raphaelchang/dragonflyte-hardware/Dragonflyte/Boards/Dragonfleye/CAD/LensMount.STEP

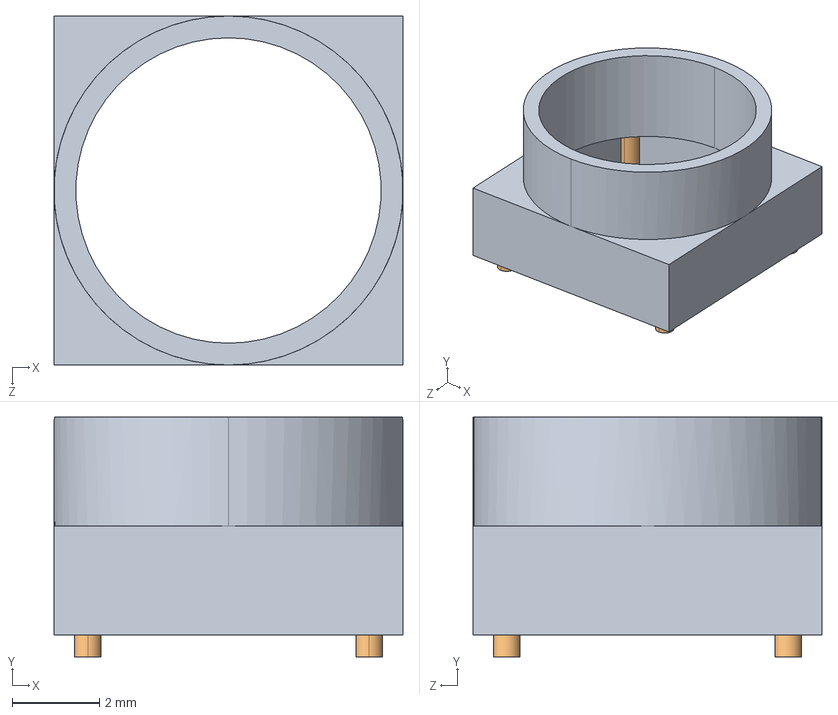
[picture p1: CAD file, 2018-10-28]
Dragonflyte/Boards/Dragonfleye/CAD/LensMount.STEP
8.00 x 5.50 x 8.00 mm
