raphaelchang/dragonflyte-hardware/Dragonflyte/Boards/Dragonfleye/Project Outputs for Dragonfleye/STEP/Dragonfleye.step

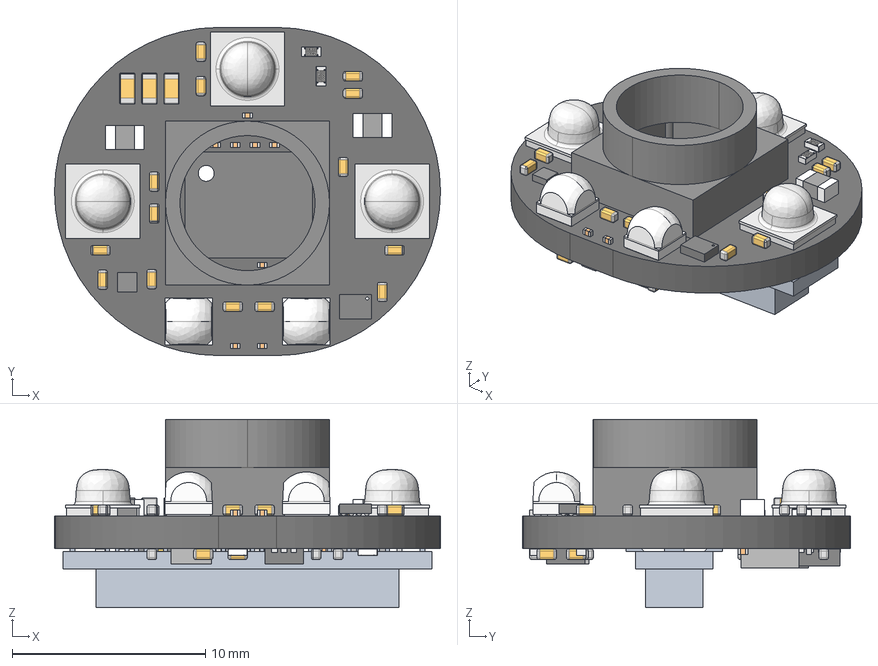
[picture p2: CAD file, 2018-01-28]
Dragonflyte/Boards/Dragonfleye/Project Outputs for Dragonfleye/STEP/Dragonfleye.step
20.0 x 17.0 x 9.75 mm
Board
Open_CASCADE_STEP_translator_6.8_2.1
Open_CASCADE_STEP_translator_6.8_2.2.1
ball x 56
Extruded x 43
User_Library-RESC1005X04N x 7
CREE,_XLamp_XB-H_RGB15724527 x 2
CAPC1005X55N_EIA_0402 x 23
LQM21NN0_1-2_2u x 2
60R-JMDSS-G-1-TF(S)
SFH_4715AS_110615_geometry_RGB13421772 x 3
Open_CASCADE_STEP_translator_6.8_14.1
Open_CASCADE_STEP_translator_6.8_14.2.1
Open_CASCADE_STEP_translator_6.8_24.1
Open_CASCADE_STEP_translator_6.8_24.2.1
Thermal_Shape x 2
Open_CASCADE_STEP_translator_6.8_24.4.1 x 6
Open_CASCADE_STEP_translator_6.8_12.1
Open_CASCADE_STEP_translator_6.8_12.2.1
Open_CASCADE_STEP_translator_6.8_12.4.1 x 28
CAPC1608X92N_EIA_0603 x 3
LensMount_RGB4408131
