raphaelchang/dragonflyte-hardware/Dragonflyte/Boards/Dragonflyte/CAD/Outline.SLDPRT

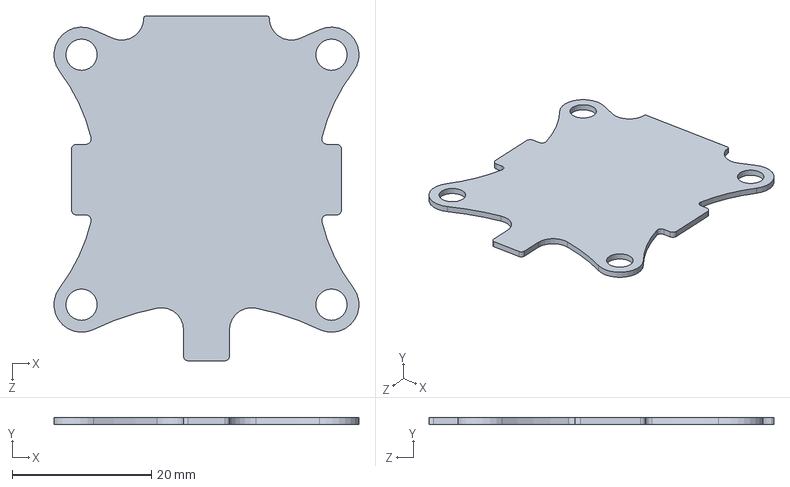
[picture p3: CAD file, 2018-01-07]
Dragonflyte/Boards/Dragonflyte/CAD/Outline.SLDPRT
43.8 x 1.00 x 49.5 mm
