raphaelchang/dragonflyte-hardware/Dragonflyte/Boards/Dragonfleye/CAD/Outline.SLDPRT

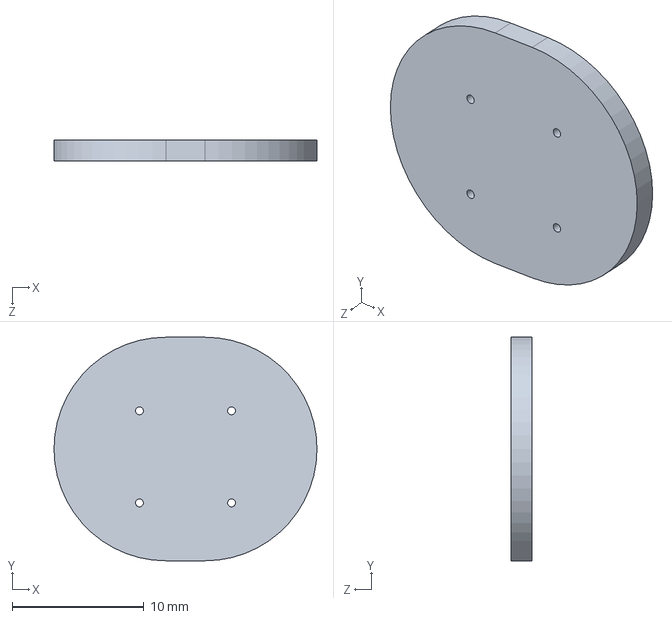
[picture p4: CAD file, 2018-01-25]
Dragonflyte/Boards/Dragonfleye/CAD/Outline.SLDPRT
20.0 x 17.0 x 1.60 mm
