raphaelchang/dragonflyte-hardware/(list of files, cad)

Other CAD files:
Dragonflyte/Boards/Dragonfleye/CAD/CameraSketch.SLDPRT
Dragonflyte/Boards/Dragonfleye/CAD/LensMount.SLDPRT
Dragonflyte/Boards/Dragonfleye/CAD/Outline.DXF
Dragonflyte/Boards/Dragonflyte/CAD/Outline.DXF
