raphaelchang/dragonflyte-hardware/Dragonflyte/Boards/Dragonfleye/Project Outputs for Dragonfleye/PDF/Dragonfleye.PDF

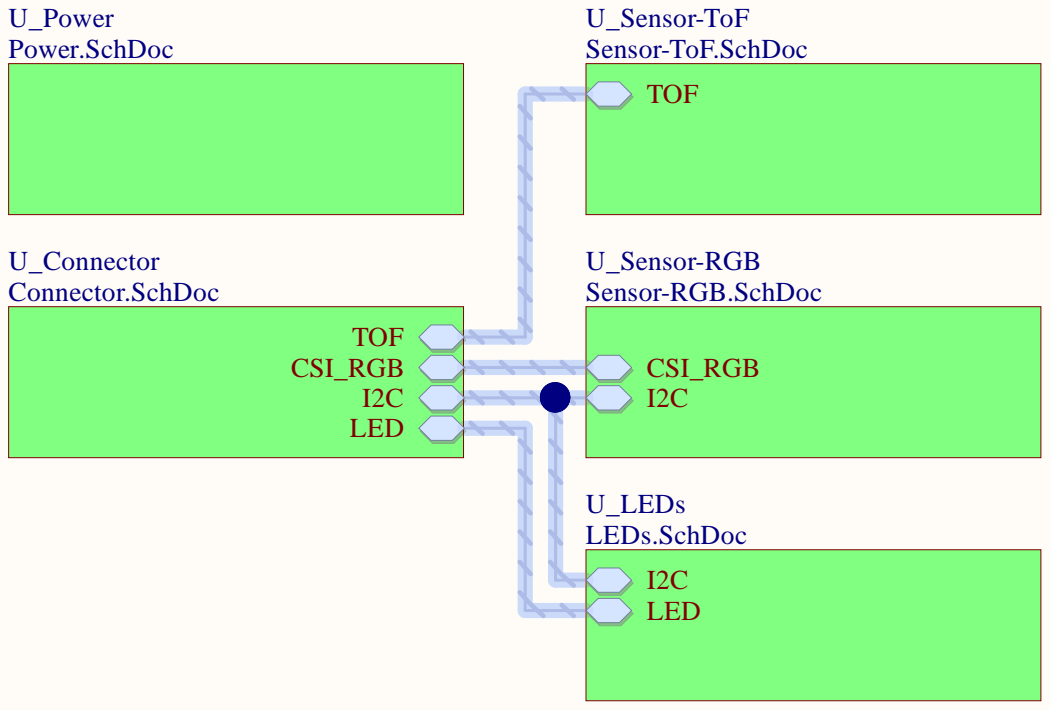
[picture p5: page 1]

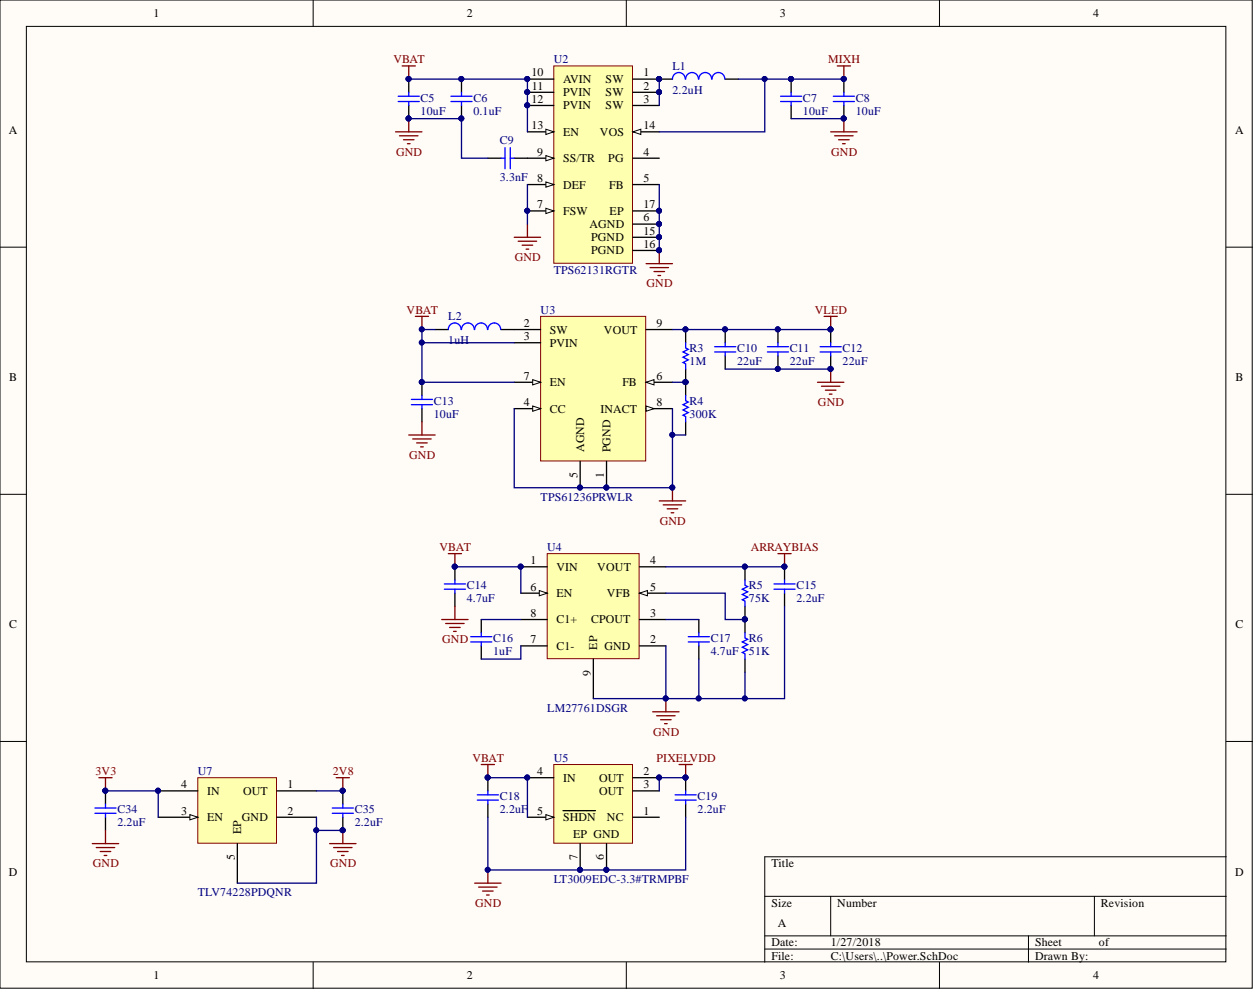
[picture p6: page 2]

1uH | PVIN 3

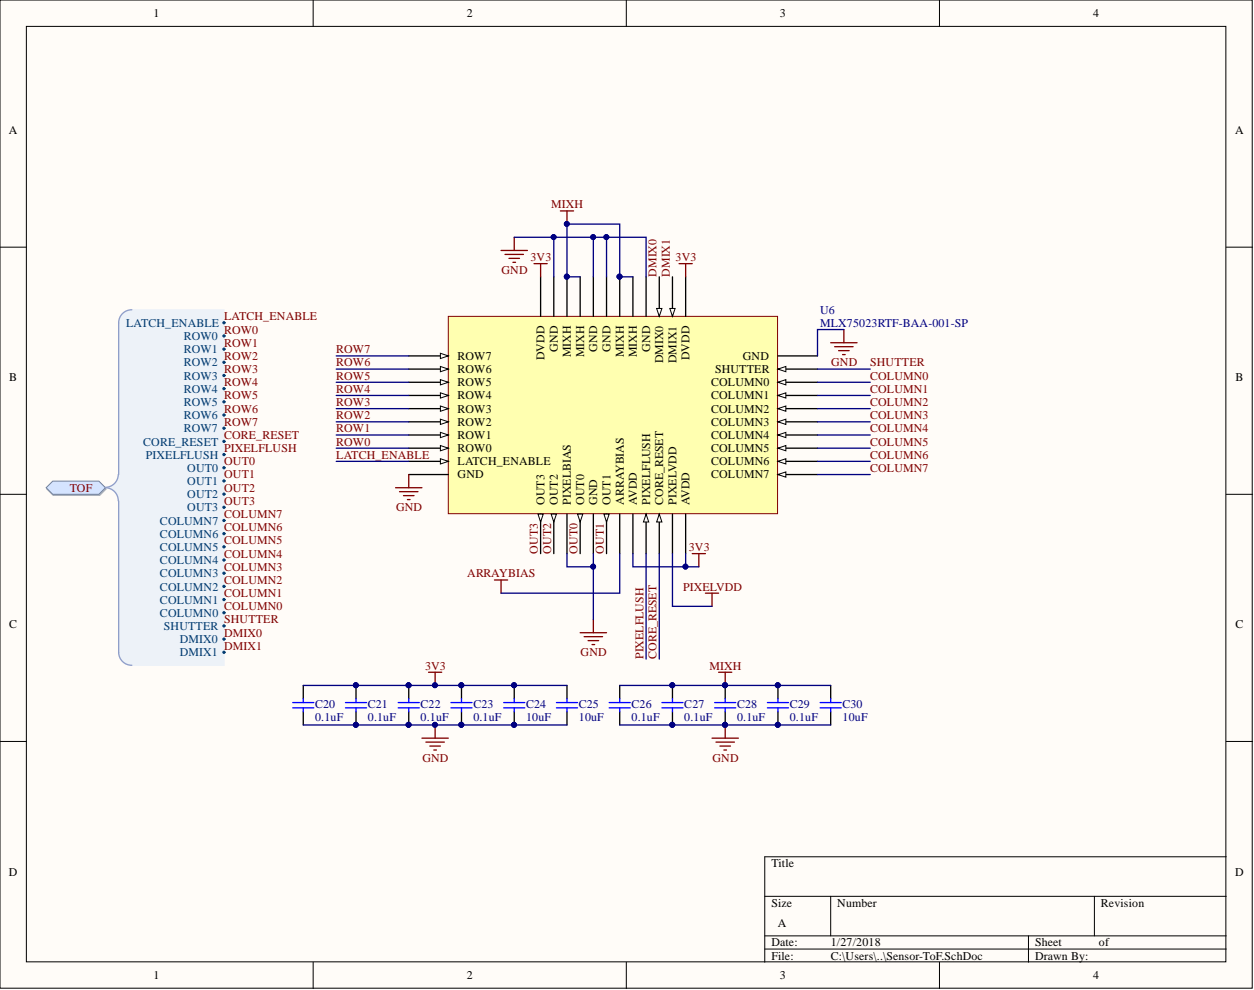
[picture p7: page 3]

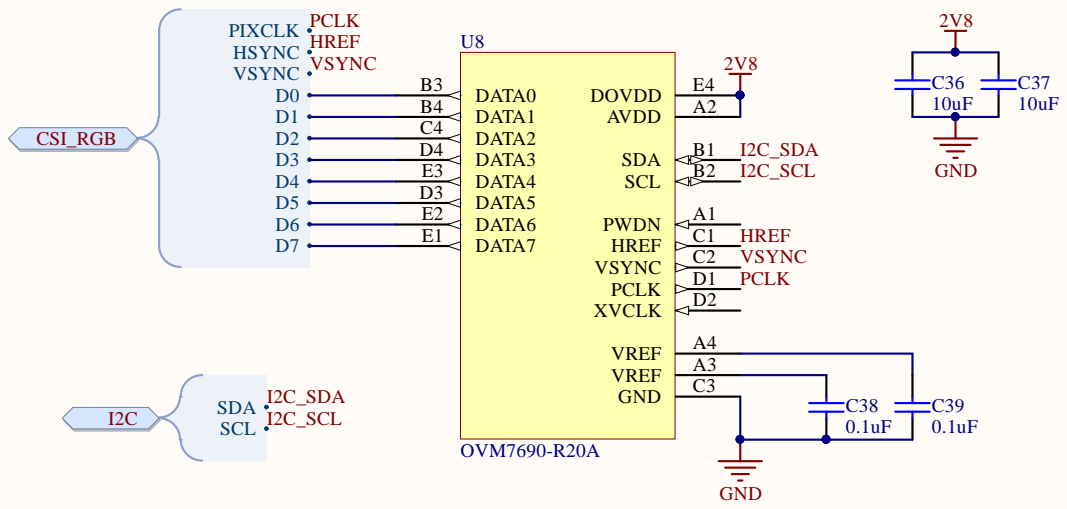
[picture p8: page 4]

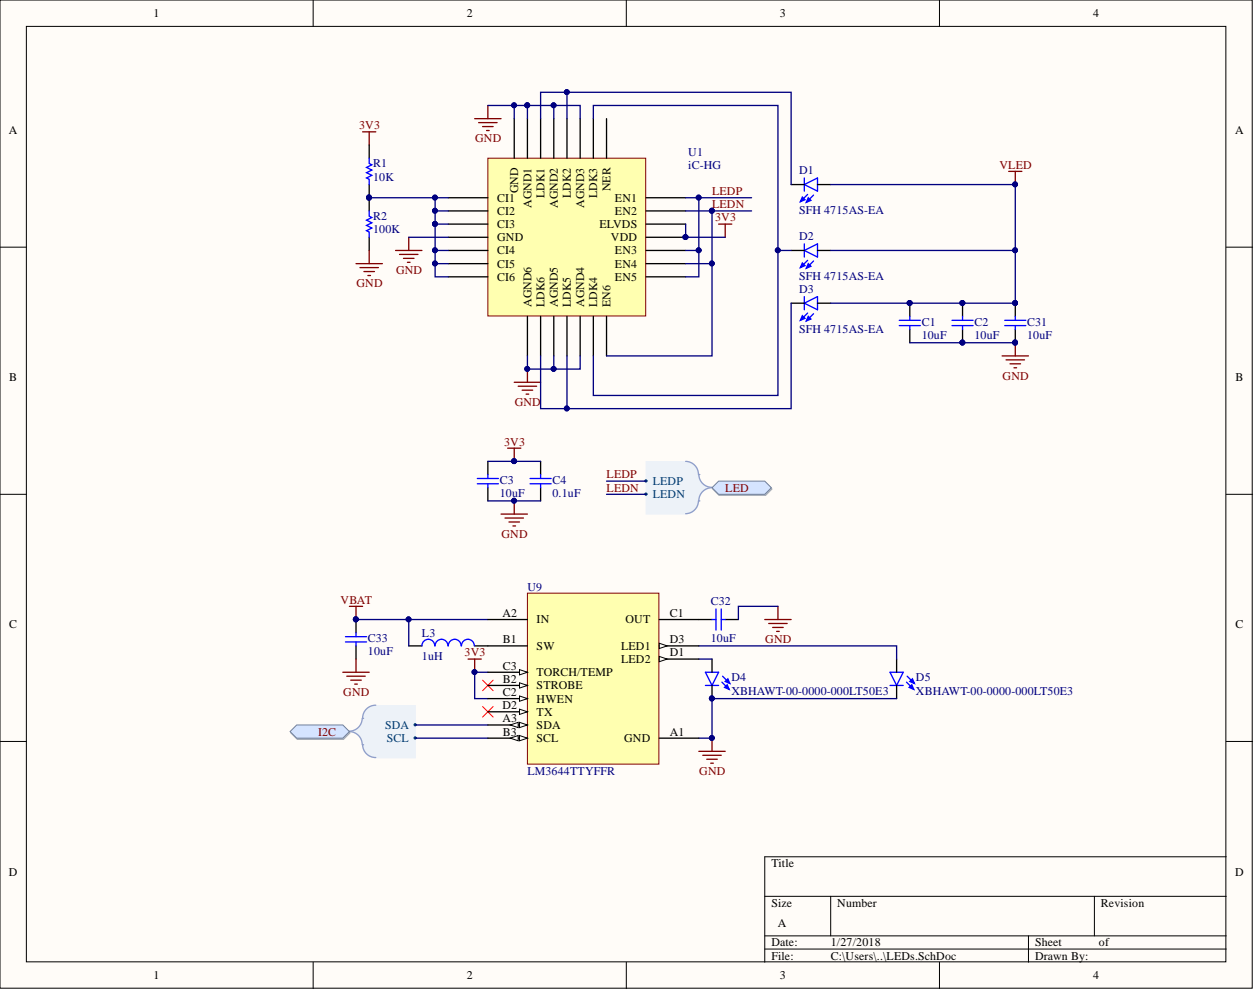
[picture p9: page 5]

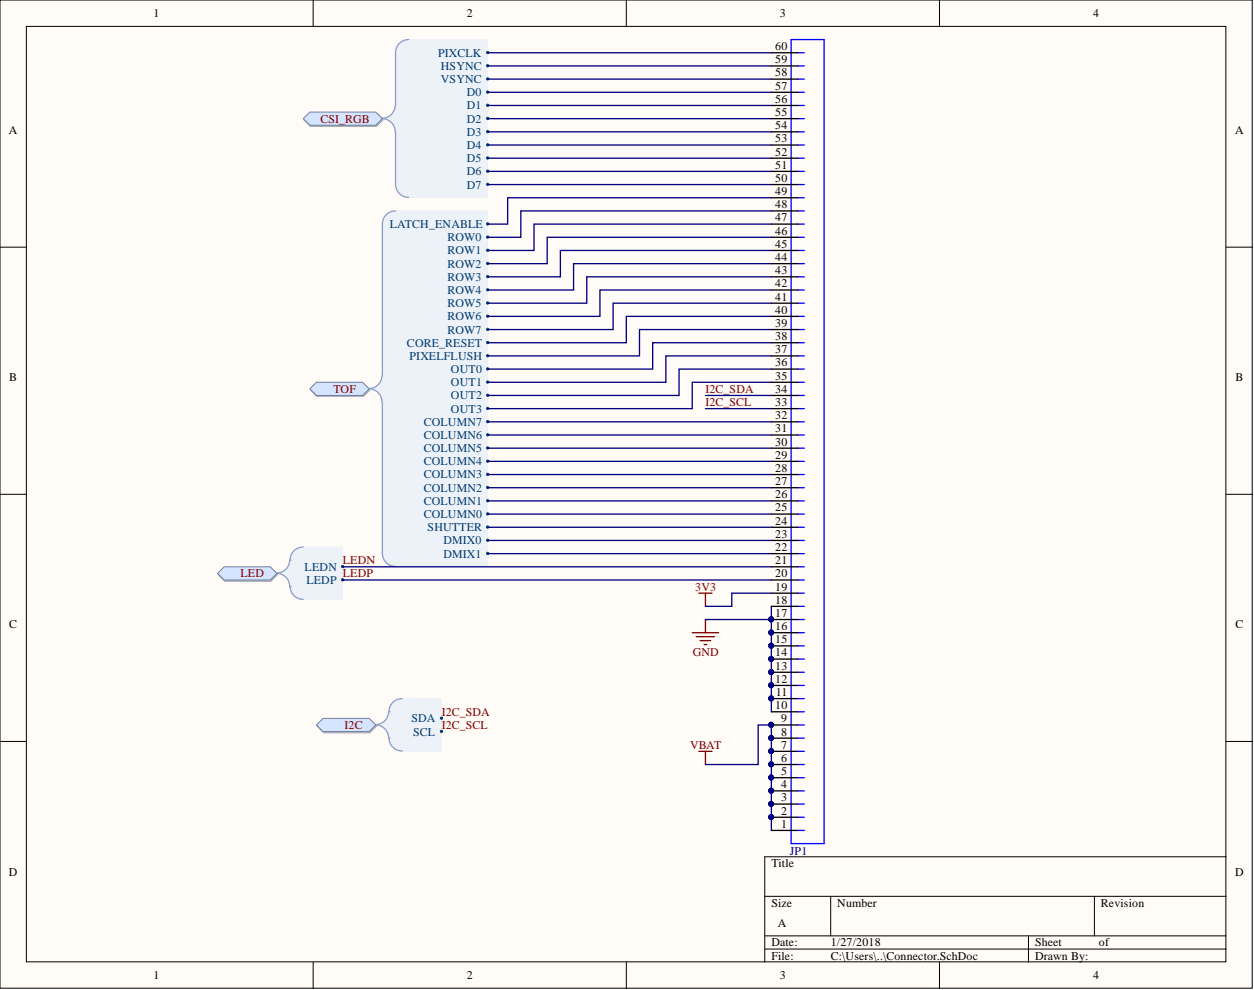
[picture p10: page 6]

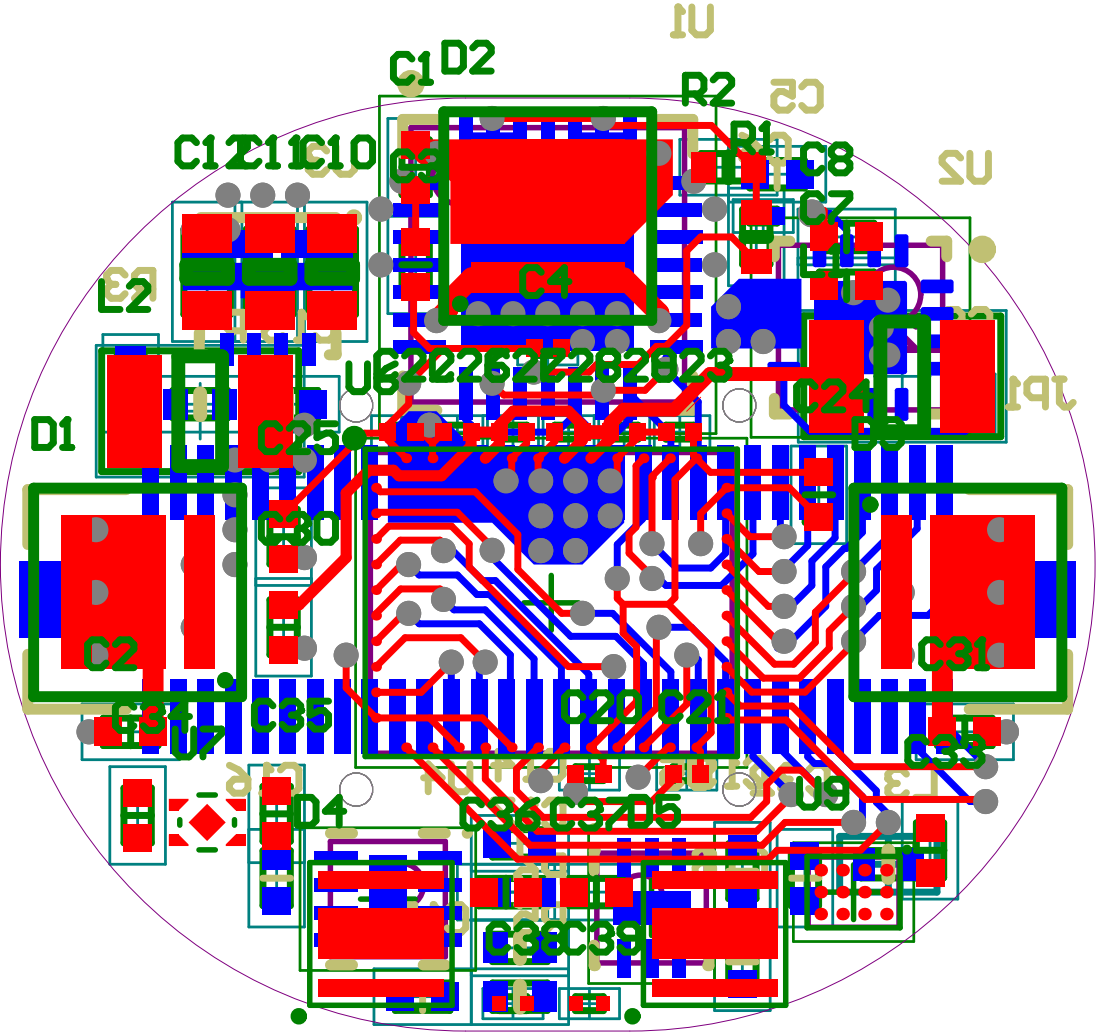
[picture p11: page 7]

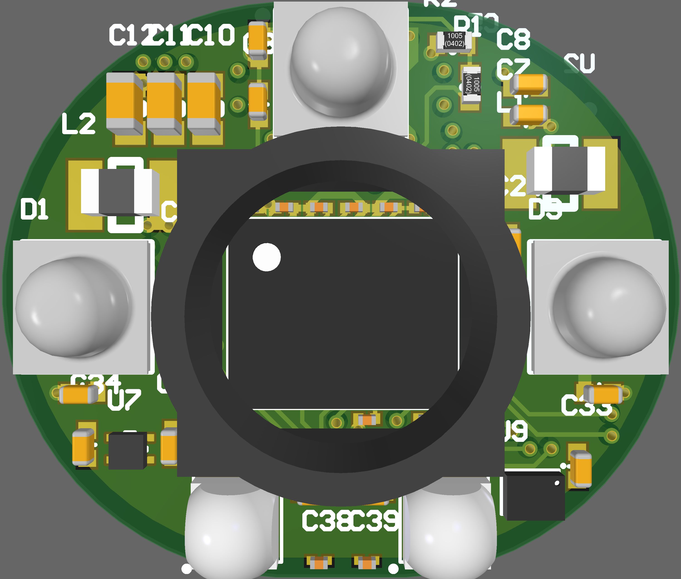
[picture p12: page 8]

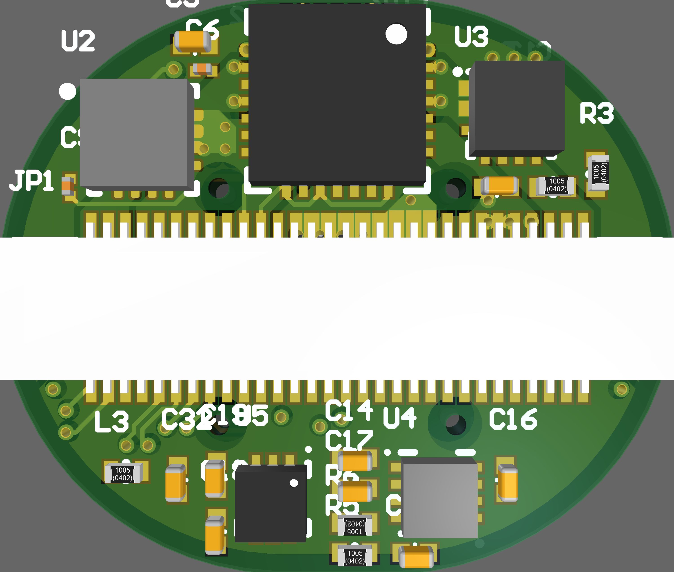
[picture p13: page 9]
