raphaelchang/dragonflyte-hardware/(list of files, drawings)

Other design files:
Dragonflyte/Boards/Dragonfleye/Connector.SchDoc
Dragonflyte/Boards/Dragonfleye/Dragonfleye.PcbDoc
Dragonflyte/Boards/Dragonfleye/Dragonfleye.PrjPcb
Dragonflyte/Boards/Dragonfleye/Dragonfleye.SchDoc
Dragonflyte/Boards/Dragonfleye/LEDs.SchDoc
Dragonflyte/Boards/Dragonfleye/Power.SchDoc
Dragonflyte/Boards/Dragonfleye/Sensor-RGB.SchDoc
Dragonflyte/Boards/Dragonfleye/Sensor-ToF.SchDoc
Dragonflyte/Boards/Dragonflyte/Cameras.SchDoc
Dragonflyte/Boards/Dragonflyte/Components.SchLib
Dragonflyte/Boards/Dragonflyte/Dragonflyte.PrjPcb
Dragonflyte/Boards/Dragonflyte/Dragonflyte.SchDoc
Dragonflyte/Boards/Dragonflyte/Footprints.PcbLib
Dragonflyte/Boards/Dragonflyte/MicrophoneArray.SchDoc
Dragonflyte/Boards/Dragonflyte/MPU-Control.SchDoc
Dragonflyte/Boards/Dragonflyte/MPU-Memory.SchDoc
Dragonflyte/Boards/Dragonflyte/MPU-Peripherals.SchDoc
Dragonflyte/Boards/Dragonflyte/MPU-Power.SchDoc
Dragonflyte/Boards/Dragonflyte/PowerCommConnector.SchDoc
Dragonflyte/Boards/Dragonflyte/PWMDriver.SchDoc
Dragonflyte/Boards/Dragonflyte/Sensors.SchDoc
Dragonflyte/Boards/Dragonflyte/Supplies.SchDoc
Dragonflyte/Boards/Dragonflyte/USB.SchDoc
Dragonflyte/Boards/Dragonflyte/UWB.SchDoc
Dragonflyte/Boards/Dragonflyte/WiFi.SchDoc
Dragonflyte/Dragonflyte.PcbDoc
