raphaelchang/dragonflyte-hardware/(commit log)

2017-11-23 Started design
    [MPU-Control.SchDoc, MPU-Memory.SchDoc, MPU-Power.SchDoc, Power.SchDoc, Supplies.SchDoc, TinyTOF-Body.PrjPcb, TinyTOF-Lens.PrjPcb]
2017-11-25 DDR3 routing is such a mess
    [MPU-Memory.SchDoc, MPU-Power.SchDoc, TinyTOF-Body.PcbDoc, TinyTOF-Body.PrjPcb]
2017-11-26 Match all the lengths!!!!!
    [TinyTOF-Body.PcbDoc]
2017-11-26 balanced clocks
    [TinyTOF-Body.PcbDoc]
2017-11-26 +termination resistor
    [MPU-Memory.SchDoc, TinyTOF-Body.PcbDoc]
2017-12-02 Finished processor schematics, started layout
    [Components.SchLib, Footprints.PcbLib, MPU-Control.SchDoc, MPU-Memory.SchDoc, MPU-Peripherals.SchDoc, MPU-Power.SchDoc, Supplies.SchDoc, TinyTOF-Body.PcbDoc]
2017-12-08 Add logo
    [Dragonflyte.PrjPcb, Outline.DXF, Outline.SLDPRT]
2017-12-10 made smaller
    [Outline.DXF, Outline.SLDPRT]
2017-12-14 continuing schematic
    [Cameras.SchDoc, Components.SchLib, Dragonflyte.PrjPcb, Dragonflyte.SchDoc, Footprints.PcbLib, MPU-Control.SchDoc, MPU-Peripherals.SchDoc, MicrophoneArray.SchDoc]
2017-12-14 Add cameras
    [Cameras.SchDoc, Components.SchLib, Dragonflyte.PrjPcb, Dragonflyte.SchDoc, Footprints.PcbLib]
2017-12-14 Finished schematic for now
    [Cameras.SchDoc, Dragonflyte.PrjPcb, Dragonflyte.SchDoc, MPU-Control.SchDoc, MPU-Peripherals.SchDoc, MicrophoneArray.SchDoc, PowerBoardConnector.SchDoc, Sensors.SchDoc]
2017-12-16 Almost done with layout, started routing
    [Cameras.SchDoc, MicrophoneArray.SchDoc, PowerBoardConnector.SchDoc, Supplies.SchDoc]
2017-12-16 more layout
    [Supplies.SchDoc]
2017-12-17 outline changes
    [MPU-Peripherals.SchDoc, Outline.DXF, Outline.SLDPRT]
2018-01-03 Finished placement
    [Cameras.SchDoc, Dragonflyte.PrjPcb, Sensors.SchDoc]
2018-01-06 Small layout changes
    [Footprints.PcbLib, Outline.DXF, Outline.SLDPRT]
2018-01-07 Started camera routing
    [Dragonflyte.SchDoc, Outline.DXF, Outline.SLDPRT, Sensors.SchDoc, Supplies.SchDoc]
2018-01-08 Finished most routing
    [MPU-Control.SchDoc, PowerBoardConnector.SchDoc, Supplies.SchDoc, USB.SchDoc]
2018-01-18 antenna layout changes
    [Components.SchLib, Footprints.PcbLib, WiFi.SchDoc]
2018-01-22 Started dragonfleye
    [CameraSketch.SLDPRT, Dragonfleye.PcbDoc, Dragonfleye.PrjPcb, Dragonfleye.step, LensMount.SLDPRT, LensMount.STEP, Outline.DXF, Outline.SLDPRT]
2018-01-24 Mostly finished camera schematic
    [Cameras.SchDoc, Connector.SchDoc, Dragonfleye.PcbDoc, Dragonfleye.PrjPcb, Dragonfleye.SchDoc, Dragonfleye.step, Dragonflyte.PrjPcb, LEDs.SchDoc]
2018-01-25 Dragonfleye routing
    [Cameras.SchDoc, Connector.SchDoc, Dragonfleye.PcbDoc, Dragonfleye.PrjPcb, Dragonfleye.SchDoc, Dragonfleye.step, LEDs.SchDoc, Outline.DXF]
2018-01-27 Add white LEDs
    [Dragonfleye.PcbDoc, Dragonfleye.PrjPcb, Dragonfleye.SchDoc, Dragonfleye.step, LEDs.SchDoc, Power.SchDoc, Sensor-RGB.SchDoc]
2018-01-28 Output pdfs
    [CameraSketch.SLDPRT, Dragonfleye.PcbDoc, Dragonfleye.PrjPcb, Dragonfleye.step, Dragonflyte.PrjPcb, LensMount.SLDPRT, LensMount.STEP, Outline.DXF]
2018-01-28 Fix sheet ordering
    [Cameras.SchDoc, Connector.SchDoc, Dragonfleye.SchDoc, Dragonflyte.PrjPcb, Dragonflyte.SchDoc, LEDs.SchDoc, MPU-Control.SchDoc, MPU-Memory.SchDoc]
2018-06-11 Restructure as multiboard project
    [CameraSketch.SLDPRT, Cameras.SchDoc, Components.SchLib, Connector.SchDoc, Dragonfleye.PcbDoc, Dragonfleye.PrjPcb, Dragonfleye.SchDoc, Dragonfleye.step]
2018-10-04 clock cap
    [Cameras.SchDoc, Components.SchLib]
2018-10-09 m7 lens mount update
    [Dragonfleye.PcbDoc, LensMount.SLDPRT, LensMount.STEP]
2018-10-11 Finally finished routing
    [Footprints.PcbLib]
2018-10-22 voltage clamp
    [Dragonfleye.PcbDoc, Supplies.SchDoc]
2018-10-28 Board clearance rules
    [Dragonflyte.SchDoc, LensMount.SLDPRT, LensMount.STEP]
2018-10-30 Add BOM
    [Dragonflyte.xls]
2018-10-30 fix bom
    [Dragonflyte.xls, Sensors.SchDoc, UWB.SchDoc]
2018-10-30 Pin markers
    [Footprints.PcbLib]
2018-11-23 Add MIPI camera support
    [Cameras.SchDoc, Components.SchLib, Dragonflyte.PrjPcb, Dragonflyte.SchDoc, MPU-Peripherals.SchDoc, Supplies.SchDoc]
2018-11-24 Extra camera power supplies
    [Cameras.SchDoc, Supplies.SchDoc]
2018-12-03 Tof chip upgrade and trigger signal
    [Cameras.SchDoc, Dragonflyte.SchDoc, MPU-Peripherals.SchDoc, Supplies.SchDoc]
2018-12-03 update pdf
    [Supplies.SchDoc]
2018-12-03 update bom
    [Dragonflyte.csv, Dragonflyte.xls]
2018-12-04 qspi flash
    [Dragonflyte.csv, Dragonflyte.xls, Dragonflyte.xlsx, MPU-Peripherals.SchDoc, USB.SchDoc]
2018-12-05 Power connector change + more comm ports
    [Dragonflyte.PrjPcb, Dragonflyte.SchDoc, Dragonflyte.csv, Dragonflyte.xls, Dragonflyte.xlsx, MPU-Peripherals.SchDoc, MicrophoneArray.SchDoc, PWMDriver.SchDoc]
2018-12-05 connector swap
    [Cameras.SchDoc, Dragonflyte.csv, Dragonflyte.xls, Dragonflyte.xlsx, PowerCommConnector.SchDoc]
2019-02-05 Add IMU fsync
    [Dragonflyte.SchDoc, Sensors.SchDoc]
